mfacton/cpld-display/pcb/cpld-display.kicad_pcb

## KiCad design pcb/cpld-display.kicad_pcb (2024-09-30)

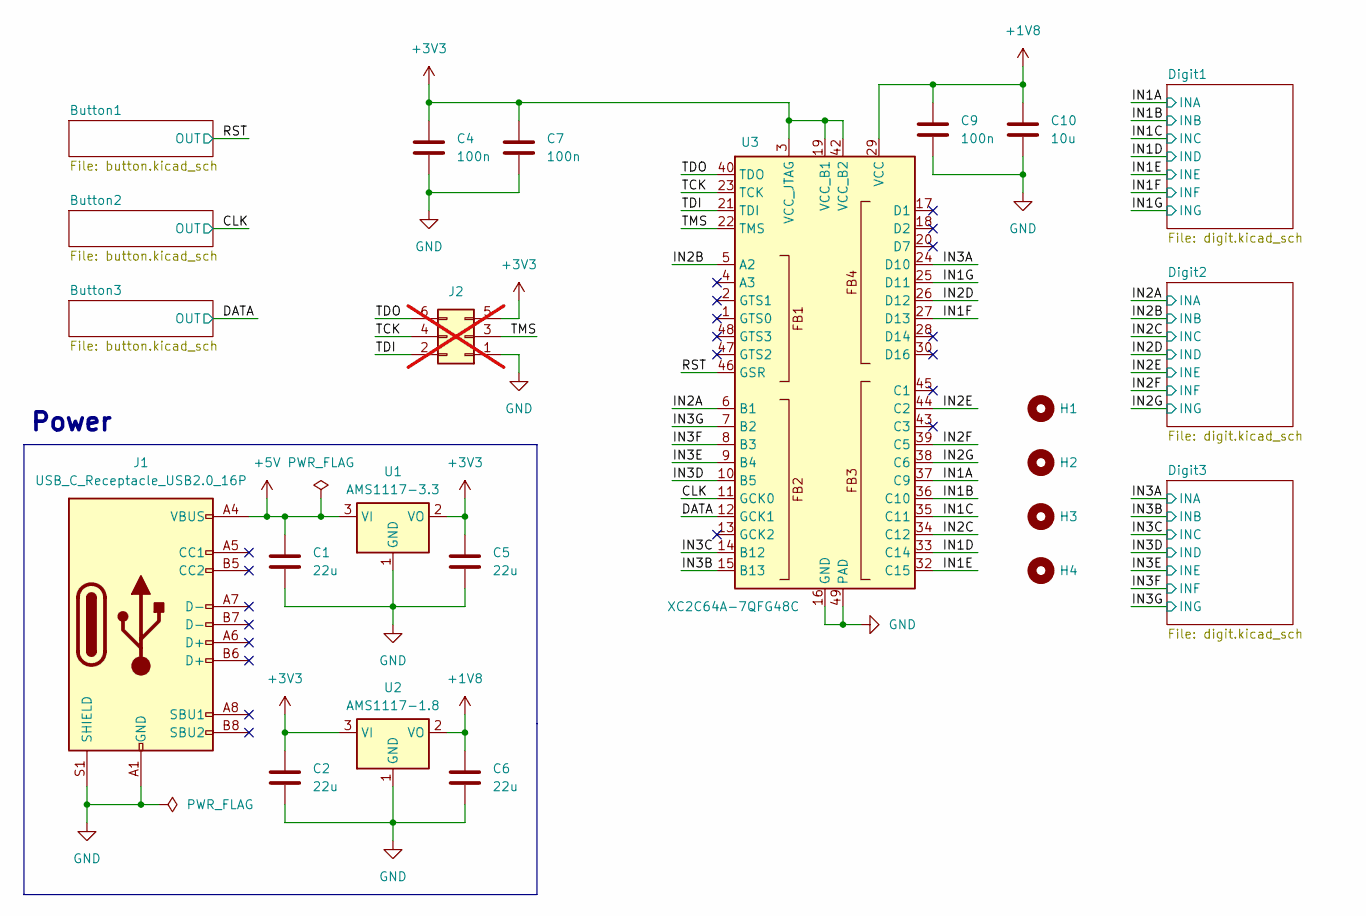
[picture p1: schematic cpld-display.kicad_sch]

Parts:
C1: 22u; C_0805_2012Metric; LCSC C45783
C2, C5, C6: 22u; C_0603_1608Metric; LCSC C59461
C4, C7, C9: 100n; C_0402_1005Metric; LCSC C1525
C10: 10u; C_0402_1005Metric; LCSC C15525
H1, H2, H3, H4: MountingHole; MountingHole_3.2mm_M3
J1: USB_C_Receptacle_USB2.0_16P; USB_C_Receptacle_GCT_USB4105-xx-A_16P_TopMnt_Horizontal; LCSC C165948
J2: Conn_02x03_Odd_Even; PinHeader_2x03_P2.54mm_Vertical; not fitted
U1: AMS1117-3.3; SOT-223-3_TabPin2; LCSC C6186
U2: AMS1117-1.8; SOT-223-3_TabPin2; LCSC C347220
U3: XC2C64A-7QFG48C; QFN-48-1EP_7x7mm_P0.5mm_EP5.15x5.15mm; LCSC C1519023

Connections:
+1V8: C6.1, C9.1, C10.1, U2.2 (VO), U3.29 (VCC)
+3V3: C2.1, C4.1, C5.1, C7.1, J2.5, U1.2 (VO), U2.3 (VI), U3.3 (VCC_JTAG), U3.19 (VCC_B1), U3.42 (VCC_B2); also elsewhere on the board
+5V: C1.1, J1.A4 (VBUS), J1.A9 (VBUS), J1.B4 (VBUS), J1.B9 (VBUS), U1.3 (VI)
/CLK: U3.11 (GCK0); also elsewhere on the board
/DATA: U3.12 (GCK1); also elsewhere on the board
/IN1A: U3.37 (C9); also elsewhere on the board
/IN1B: U3.36 (C10); also elsewhere on the board
/IN1C: U3.35 (C11); also elsewhere on the board
/IN1D: U3.33 (C14); also elsewhere on the board
/IN1E: U3.32 (C15); also elsewhere on the board
/IN1F: U3.27 (D13); also elsewhere on the board
/IN1G: U3.25 (D11); also elsewhere on the board
/IN2A: U3.6 (B1); also elsewhere on the board
/IN2B: U3.5 (A2); also elsewhere on the board
/IN2C: U3.34 (C12); also elsewhere on the board
/IN2D: U3.26 (D12); also elsewhere on the board
/IN2E: U3.44 (C2); also elsewhere on the board
/IN2F: U3.39 (C5); also elsewhere on the board
/IN2G: U3.38 (C6); also elsewhere on the board
/IN3A: U3.24 (D10); also elsewhere on the board
/IN3B: U3.15 (B13); also elsewhere on the board
/IN3C: U3.14 (B12); also elsewhere on the board
/IN3D: U3.10 (B5); also elsewhere on the board
/IN3E: U3.9 (B4); also elsewhere on the board
/IN3F: U3.8 (B3); also elsewhere on the board
/IN3G: U3.7 (B2); also elsewhere on the board
/RST: U3.46 (GSR); also elsewhere on the board
/TCK: J2.4, U3.23 (TCK)
/TDI: J2.2, U3.21 (TDI)
/TDO: J2.6, U3.40 (TDO)
/TMS: J2.3, U3.22 (TMS)
GND: C1.2, C2.2, C4.2, C5.2, C6.2, C7.2, C9.2, C10.2, J1.A1 (GND), J1.A12 (GND), J1.B1 (GND), J1.B12 (GND), J1.S1 (SHIELD), J2.1, U1.1 (GND), U2.1 (GND), U3.16 (GND), U3.31 (GND), U3.41 (GND), U3.49 (PAD); also elsewhere on the board

Notes on the sheet:
Power

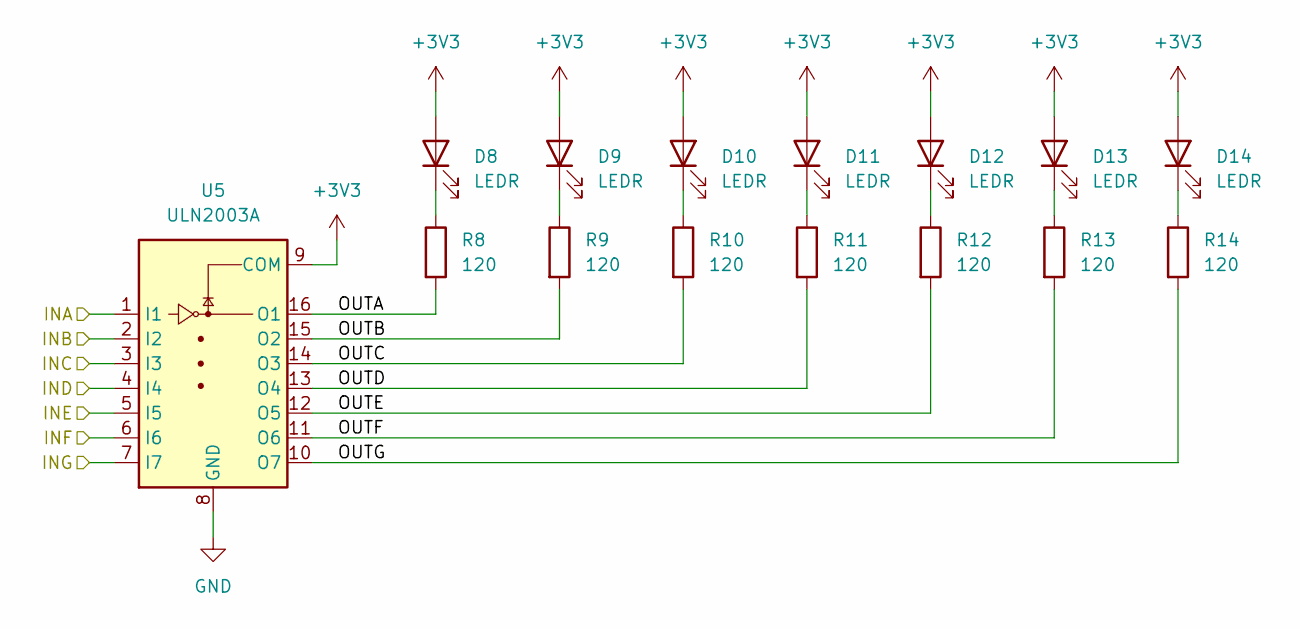
[picture p2: schematic digit.kicad_sch]

Parts:
D8, D9, D10, D11, D12, D13, D14: LEDR; LED_0603_1608Metric; LCSC C2286
R8, R9, R10, R11, R12, R13, R14: 120; R_0603_1608Metric; LCSC C22787
U5: ULN2003A; SOIC-16_3.9x9.9mm_P1.27mm; LCSC C7512

Connections:
+3V3: D8.2 (A), D9.2 (A), D10.2 (A), D11.2 (A), D12.2 (A), D13.2 (A), D14.2 (A), U5.9 (COM); also elsewhere on the board
/Digit2/OUTA: R8.2, U5.16 (O1)
/Digit2/OUTB: R9.2, U5.15 (O2)
/Digit2/OUTC: R10.2, U5.14 (O3)
/Digit2/OUTD: R11.2, U5.13 (O4)
/Digit2/OUTE: R12.2, U5.12 (O5)
/Digit2/OUTF: R13.2, U5.11 (O6)
/Digit2/OUTG: R14.2, U5.10 (O7)
/IN2A: U5.1 (I1); also elsewhere on the board
/IN2B: U5.2 (I2); also elsewhere on the board
/IN2C: U5.3 (I3); also elsewhere on the board
/IN2D: U5.4 (I4); also elsewhere on the board
/IN2E: U5.5 (I5); also elsewhere on the board
/IN2F: U5.6 (I6); also elsewhere on the board
/IN2G: U5.7 (I7); also elsewhere on the board
GND: U5.8 (GND); also elsewhere on the board
unnamed: D8.1 (K), R8.1
unnamed: D9.1 (K), R9.1
unnamed: D10.1 (K), R10.1
unnamed: D11.1 (K), R11.1
unnamed: D12.1 (K), R12.1
unnamed: D13.1 (K), R13.1
unnamed: D14.1 (K), R14.1

Parts of its further copies:
D1, D2, D3, D4, D5, D6, D7, D15, D16, D17, D18, D19, D20, D21: LEDR; LED_0603_1608Metric; LCSC C2286
R1, R2, R3, R4, R5, R6, R7, R15, R16, R17, R18, R19, R20, R21: 120; R_0603_1608Metric; LCSC C22787
U4, U6: ULN2003A; SOIC-16_3.9x9.9mm_P1.27mm; LCSC C7512

Connections of its further copies:
+3V3: D1.2 (A), D2.2 (A), D3.2 (A), D4.2 (A), D5.2 (A), D6.2 (A), D7.2 (A), D15.2 (A), D16.2 (A), D17.2 (A), D18.2 (A), D19.2 (A), D20.2 (A), D21.2 (A), U4.9 (COM), U6.9 (COM); also elsewhere on the board
/Digit1/OUTA: R1.2, U4.16 (O1)
/Digit1/OUTB: R2.2, U4.15 (O2)
/Digit1/OUTC: R3.2, U4.14 (O3)
/Digit1/OUTD: R4.2, U4.13 (O4)
/Digit1/OUTE: R5.2, U4.12 (O5)
/Digit1/OUTF: R6.2, U4.11 (O6)
/Digit1/OUTG: R7.2, U4.10 (O7)
/Digit3/OUTA: R15.2, U6.16 (O1)
/Digit3/OUTB: R16.2, U6.15 (O2)
/Digit3/OUTC: R17.2, U6.14 (O3)
/Digit3/OUTD: R18.2, U6.13 (O4)
/Digit3/OUTE: R19.2, U6.12 (O5)
/Digit3/OUTF: R20.2, U6.11 (O6)
/Digit3/OUTG: R21.2, U6.10 (O7)
/IN1A: U4.1 (I1); also elsewhere on the board
/IN1B: U4.2 (I2); also elsewhere on the board
/IN1C: U4.3 (I3); also elsewhere on the board
/IN1D: U4.4 (I4); also elsewhere on the board
/IN1E: U4.5 (I5); also elsewhere on the board
/IN1F: U4.6 (I6); also elsewhere on the board
/IN1G: U4.7 (I7); also elsewhere on the board
/IN3A: U6.1 (I1); also elsewhere on the board
/IN3B: U6.2 (I2); also elsewhere on the board
/IN3C: U6.3 (I3); also elsewhere on the board
/IN3D: U6.4 (I4); also elsewhere on the board
/IN3E: U6.5 (I5); also elsewhere on the board
/IN3F: U6.6 (I6); also elsewhere on the board
/IN3G: U6.7 (I7); also elsewhere on the board
GND: U4.8 (GND), U6.8 (GND); also elsewhere on the board
unnamed: D1.1 (K), R1.1
unnamed: D2.1 (K), R2.1
unnamed: D3.1 (K), R3.1
unnamed: D4.1 (K), R4.1
unnamed: D5.1 (K), R5.1
unnamed: D6.1 (K), R6.1
unnamed: D7.1 (K), R7.1
unnamed: D15.1 (K), R15.1
unnamed: D16.1 (K), R16.1
unnamed: D17.1 (K), R17.1
unnamed: D18.1 (K), R18.1
unnamed: D19.1 (K), R19.1
unnamed: D20.1 (K), R20.1
unnamed: D21.1 (K), R21.1

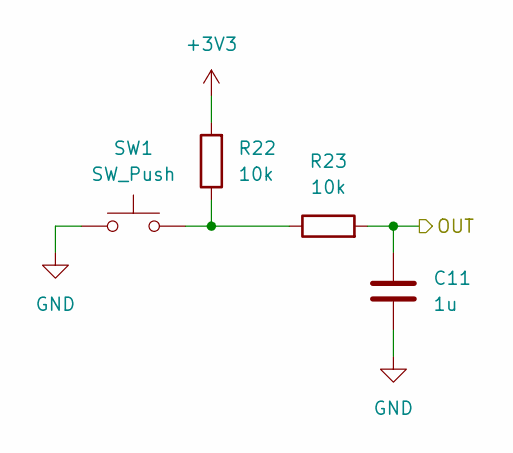
[picture p3: schematic button.kicad_sch]

Parts:
C11: 1u; C_0402_1005Metric; LCSC C52923
R22, R23: 10k; R_0402_1005Metric; LCSC C25744
SW1: SW_Push; SW_SPST_TL3342; LCSC C318884

Connections:
+3V3: R22.2; also elsewhere on the board
/RST: C11.1, R23.2; also elsewhere on the board
GND: C11.2, SW1.1; also elsewhere on the board
unnamed: R22.1, R23.1, SW1.2

Parts of its further copies:
C12, C13: 1u; C_0402_1005Metric; LCSC C52923
R24, R25, R26, R27: 10k; R_0402_1005Metric; LCSC C25744
SW2, SW3: SW_Push; SW_SPST_TL3342; LCSC C318884

Connections of its further copies:
+3V3: R24.2, R26.2; also elsewhere on the board
/CLK: C12.1, R25.2; also elsewhere on the board
/DATA: C13.1, R27.2; also elsewhere on the board
GND: C12.2, C13.2, SW2.1, SW3.1; also elsewhere on the board
unnamed: R24.1, R25.1, SW2.2
unnamed: R26.1, R27.1, SW3.2

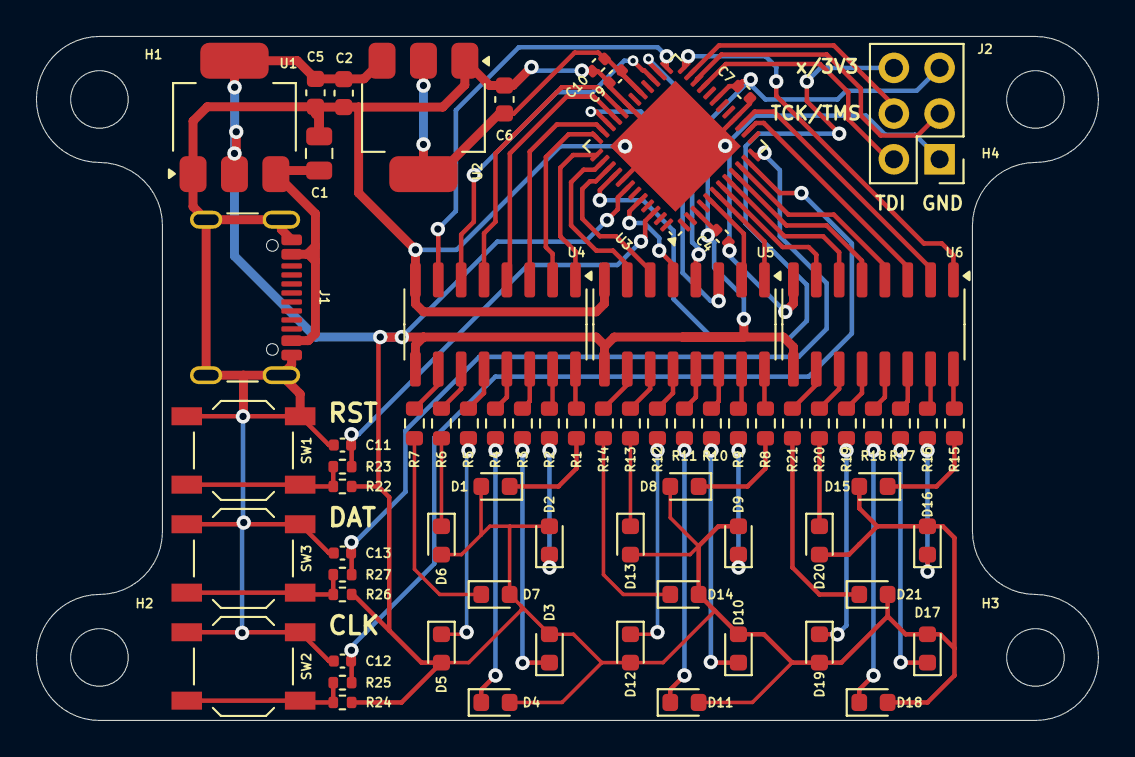
[picture p4: board cpld-display.kicad_pcb from above]

Board: 2 copper layers, 59.0 x 38.0 mm, 74 parts (0 on the bottom side), 77 nets.
