mfacton/cpld-display/firmware/stm-pulse-ide/Core/Inc/main.h

#define BTN_Pin GPIO_PIN_13
#define BTN_GPIO_Port GPIOC
#define LED_Pin GPIO_PIN_5
#define LED_GPIO_Port GPIOA
#define SIG_Pin GPIO_PIN_8
#define SIG_GPIO_Port GPIOB
