mfacton/cpld-display/firmware/cpld-display/bcd_display.v

`timescale 1ns / 1ps

module bcd_display(in, out);
input [3:0]in;
output [6:0]out;

assign out[3:0] = in;

/*
always @(*) begin
case (in)
	4'b0000: out = 7'b0111111;
	4'b0001: out = 7'b0000110;
	4'b0010: out = 7'b1011011;
	4'b0011: out = 7'b1001111;
	4'b0100: out = 7'b1100110;
	4'b0101: out = 7'b1101101;
	4'b0110: out = 7'b1111101;
	4'b0111: out = 7'b0000111;
	4'b1000: out = 7'b1111111;
	4'b1001: out = 7'b1101111;
	
	// other digits
	4'b1010: out = 7'b1110111;
	4'b1011: out = 7'b1111100;
	4'b1100: out = 7'b0111001;
	4'b1101: out = 7'b1011110;
	4'b1110: out = 7'b1111001;
	4'b1111: out = 7'b1110001;
endcase
end
*/

endmodule
