mfacton/cpld-display/(commit log)

2024-09-05 Finish pcb and confim verilog configuration and code
    [bom.csv, button.kicad_sch, dabble_reg.sch, designators.csv, digit.kicad_sch, positions.csv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]
2024-09-09 Final design
    [cpld-display.kicad_pcb]
2024-09-09 Change jtag production properties
    [bom.csv, positions.csv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]
2024-09-30 Fix jtag tdo pin
    [bom.csv, designators.csv, positions.csv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]
2024-10-02 Save project
    [top_pad.csv]
